bt-soft/NanoSpotWelder/README.md

# NanoSpotWelder
MOT Spot Welder Controller with Arduino Nano V3 and ATmega328P microcontroller

Full description of the project: [http://electrodiy.blog.hu/](http://electrodiy.blog.hu/2018/05/14/impulzusszamlalasos_diy_ponthegeszto_arduino_nano-val_es_atmega328p_avr_mikrokontrollerrel)

### V0.0.2 - 2018.05.23
A firmware kiegészült az impulzuscsomagok ismétlésének funkciójával. 
Új menüpontok:
 * **Packets cnt**: csomagok ismétlésének száma (értékkészlet: 1-99) 
 * **Packets pause**: az ismételt csomagok közötti várakozás (értékkészlet: 1-255)

Licence
------
##### Apache License, Version 2.0
