bt-soft/NanoSpotWelder/(list of files, drawings)

Other design files:
Proteus-model/BT - Nano Spot Welder Model.pdsprj
Proteus-model/Nano Spot Welder - Arduino Model.pdsprj
Proteus-model/Nano Spot Welder - Arduino Nano 3.pdsprj
Proteus-model/Nano Spot Welder - Arduino Nano V3 Model.pdsprj
Proteus-model/Nano Spot Welder - Arduino Nano V3.pdsprj
Proteus-model/Nano Spot Welder - BareBones Model.pdsprj
