bt-soft/NanoSpotWelder/Eagle schema/nano Spot Welder 0.0.1.sch

## EAGLE design Eagle schema/nano Spot Welder 0.0.1.sch (2018-05-13, last stored version)

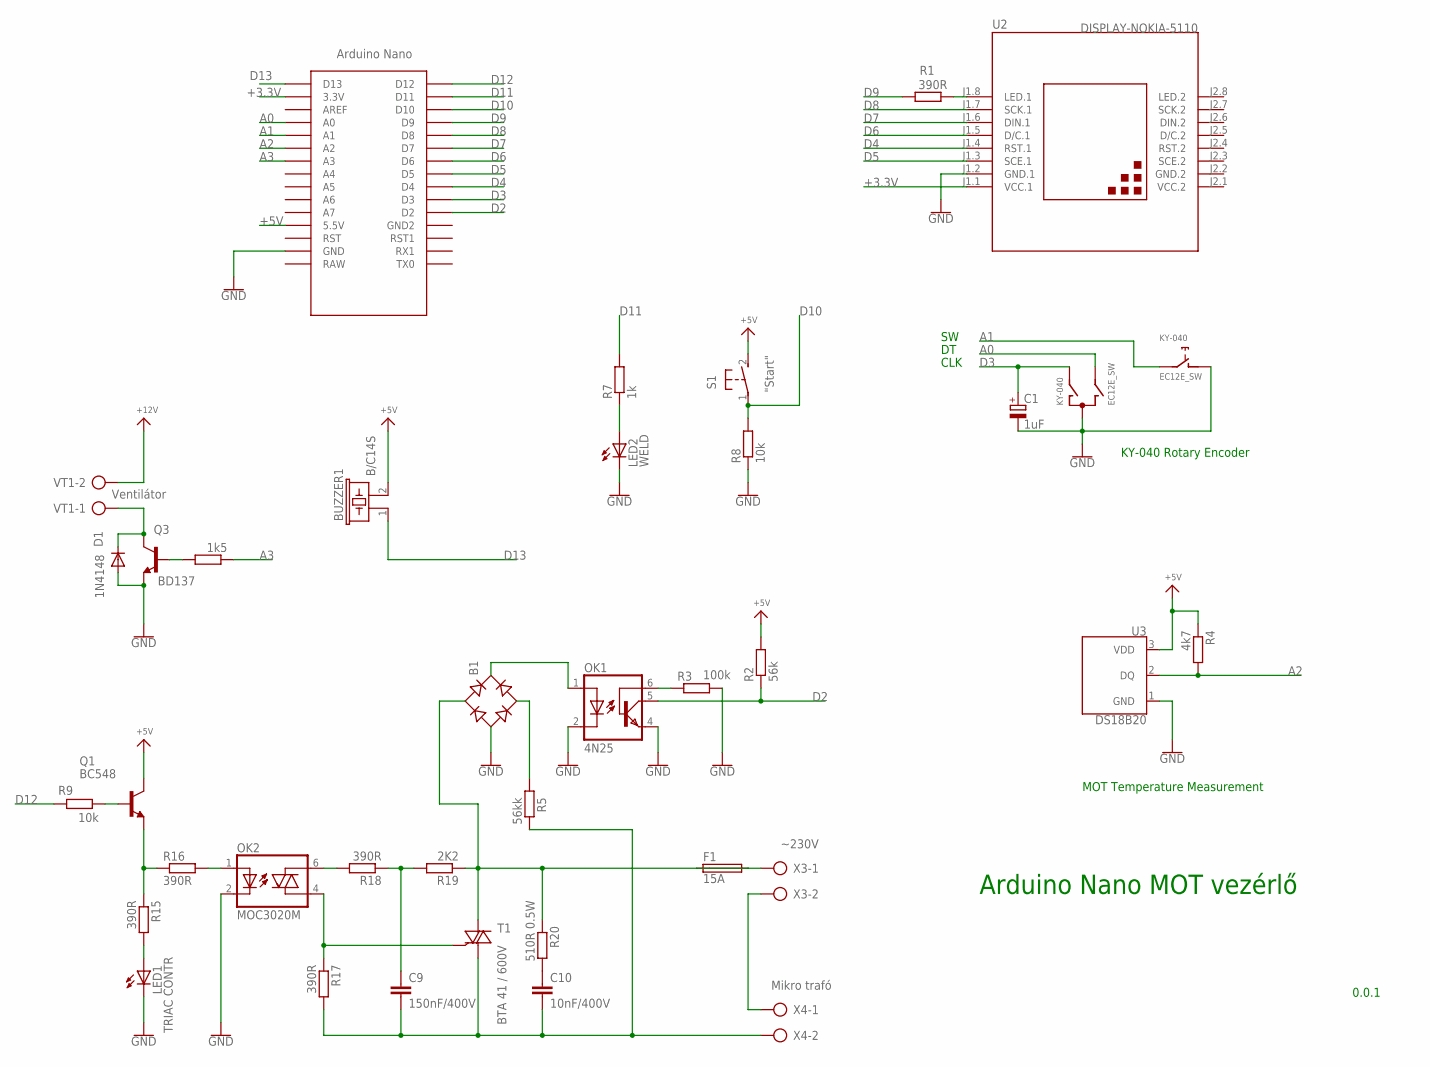
[picture p1: schematic nano Spot Welder 0.0.1.sch]

Parts:
B1: RB1A
BUZZER1: B/C14S
C1: 1uF; E5-5
C9: 150nF/400V; C5B2.5
C10: 10nF/400V; C5B2.5
D1: 1N4148; DO35-10
F1: 15A; GSH15
KY-040: EC12E_SW; ALPS_EC12E_SW
LED1: TRIAC CONTR; SMARTLED-TTW
LED2: WELD; SMARTLED-TTW
OK1: 4N25; DIL06
OK2: MOC3020M; DIL06
Q1: BC548; TO92-EBC
Q3: BD137; TO92-EBC
R1, R15, R16, R17, R18: 390R; 0204/7
R2: 56k; 0204/7
R3: 100k; 0204/7
R4: 4k7; 0204/7
R5: 56kk; 0204/7
R7: 1k; 0204/7
R8, R9: 10k; 0204/7
R10: 1k5; 0204/7
R19: 2K2; 0204/7
R20: 510R 0.5W; 0204/7
S1: 31-XX; B3F-31XX
T1: BTA 41 / 600V; TO220BV
U1: NANO
U2: DISPLAY-NOKIA-5110; DISPLAY-NOKIA-3310
U3: DS18B20; TO-92-AMMO
VT1: Ventilátor; AK300/2
X3: ~230V; AK300/2
X4: Mikro trafó; AK300/2

Connections:
+3.3V: U1.3.3V, U2.J1.1 (VCC.1)
+5V: U1.5V (5.5V)
A0: KY-040.B, U1.A0
A1: KY-040.E (2), U1.A1
A2: R4.2, U1.A2, U3.2 (DQ)
A3: R10.1, U1.A3
D2: OK1.5 (COL), R2.1, U1.D2
D3: C1.+, KY-040.A, U1.D3
D4: U1.D4, U2.J1.4 (RST.1)
D5: U1.D5, U2.J1.3 (SCE.1)
D6: U1.D6, U2.J1.5 (D/C.1)
D7: U1.D7, U2.J1.6 (DIN.1)
D8: U1.D8, U2.J1.7 (SCK.1)
D9: R1.2, U1.D9
D10: R8.2, S1.1, U1.D10
D11: R7.2, U1.D11
D12: R9.2, U1.D12
D13: BUZZER1.1, U1.D13
GND: B1.-, C1.-, D1.A, KY-040.C, KY-040.D (1), LED1.C@1 (C), LED2.C@1 (C), OK1.2 (C), OK1.4 (EMI), OK2.2 (C), Q3.E, R3.2, R8.1, U1.GND, U2.J1.2 (GND.1), U3.1 (GND)
MOC: Q1.E, R15.1, R16.1
unnamed: R1.1, U2.J1.8 (LED.1)
unnamed: OK1.6 (BAS), R3.1
unnamed: B1.+, OK1.1 (A)
unnamed: Q1.B, R9.1
unnamed: Q3.B, R10.2
unnamed: D1.C, Q3.C, VT1.1
unnamed: B1.AC2, R5.1
unnamed: OK2.6 (A2), R18.2
unnamed: LED2.A@1 (A), R7.1
unnamed: LED1.A@1 (A), R15.2
unnamed: C9.1, R18.1, R19.2
unnamed: OK2.4 (A1), R17.1, T1.G
unnamed: B1.AC1, F1.1, R19.1, R20.1, T1.T2 (A2)
unnamed: C10.1, R20.2
unnamed: X3.2, X4.1
unnamed: OK2.1 (A), R16.2
unnamed: F1.2, X3.1
unnamed: C9.2, C10.2, R5.2, R17.2, T1.T1 (A1), X4.2
VCC: BUZZER1.2, Q1.C, R2.2, R4.1, S1.2 (S), U3.3 (VDD), VT1.2

Notes on the sheet:
Arduino Nano MOT vezérlő
0.0.1
KY-040 Rotary Encoder
MOT Temperature Measurement
CLK
