bt-soft/NanoSpotWelder/RotaryEncoderWrapper.h

/*
 *
 * Copyright 2018 - BT-Soft
 *
 * Licensed under the Apache License, Version 2.0 (the "License");
 * you may not use this file except in compliance with the License.
 * You may obtain a copy of the License at
 *
 *      http://www.apache.org/licenses/LICENSE-2.0
 *
 * Unless required by applicable law or agreed to in writing, software
 * distributed under the License is distributed on an "AS IS" BASIS,
 * WITHOUT WARRANTIES OR CONDITIONS OF ANY KIND, either express or implied.
 * See the License for the specific language governing permissions and
 * limitations under the License.
 *
 * RotaryEncoderWrapper.h
 *
 *  Created on: 2018. ápr. 17.
 *      Author: bt-soft
 */

#define SMALLEST_CODESIZE
#include "ky-040.h"

#ifndef ROTARYENCODERADAPTER_H_
#define ROTARYENCODERWRAPPER_H_

//Rotary Encoder
// https://github.com/Billwilliams1952/KY-040-Encoder-Library---Arduino

/*
 * KY-040- Rotary Encoder
 *
 *
 * https://www.google.hu/imgres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
 *  +--------------+
 *  |          CLK |-- Encoder pin A
 *  |           DT |-- Encoder pin B
 *  |           SW |-- PushButton SW
 *  |         +VCC |-- +5V
 *  |          GND |-- Encoder pin C
 *  +--------------+
 *
 * https://github.com/0xPIT/encoder/issues/7
 */
/**
 * KY-040 Rotary encoder adapter
 *  - lenyomás detektálása
 *  - irány detektálása
 */
class RotaryEncoderWrapper: public ky040 {

#define ROTARY_ID1			1		/* Rotary encoder ID */

private:
	int16_t lastRotaryValue = 0;

public:
	/**
	 * Irány enum
	 */
	typedef enum Direction_t {
		UP, DOWN, NONE
	} Direction;

	/**
	 * Visszatérési érték
	 */
	typedef struct t {
		Direction_t direction;bool clicked;
	} RotaryEncoderResult;

public:
	/**
	 * Konstruktor
	 */
	RotaryEncoderWrapper(uint8_t interruptClkPin, uint8_t dataPin, uint8_t switchPin, uint8_t maxRotarys = 1) :
			ky040(interruptClkPin, dataPin, switchPin, maxRotarys) {
	}

	/**
	 * Init
	 */
	void init() {
		//--- Rotary Encoder felhúzása
		// Kezdeti érték: 0
		// Intervallum: -255...+255
		// Lépés: 1
		// Túlhajtás: igen
		ky040::AddRotaryCounter(ROTARY_ID1, 0, -255, 255, 1, true /*rollOver*/);
		ky040::SetRotary(ROTARY_ID1);
		lastRotaryValue = ky040::GetRotaryValue(ROTARY_ID1);
	}

	/**
	 * Rotary encoder olvasása, az irány meghatározása
	 */
	RotaryEncoderResult readRotaryEncoder() {

		RotaryEncoderResult result;
		result.clicked = ky040::SwitchPressed();
		result.direction = NONE;

		if (ky040::HasRotaryValueChanged(ROTARY_ID1)) {
			int16_t currentValue = ky040::GetRotaryValue(ROTARY_ID1);
			if (!result.clicked) { //Egyszerre klikkelni és tekerni nem tud
				result.direction = currentValue > lastRotaryValue ? UP : DOWN;
			}
			lastRotaryValue = currentValue;
		}

		return result;
	}
};

#endif /* ROTARYENCODERADAPTER_H_ */
