bt-soft/NanoSpotWelder/NanoSpotWelderVersion.h

/*
 * NanoSpotWelderVersion.h
 *
 *  Created on: 2018. ápr. 15.
 *      Author: BT
 */

#ifndef NSP_VERSION_H_
#define NSP_VERSION_H_


#define NSP_VERSION "0.0.1"
#define NSP_VERSION_SIZE (sizeof(NSP_VERSION))



#endif /* NSP_VERSION_H_ */
