bt-soft/NanoSpotWelder/(commit log)

2018-04-15 - LCD mainSceen - spot welding button
2018-04-15 - proteus model
    [Nano Spot Welder - Arduino Nano 3.pdsprj]
2018-04-15 - model
    [Nano Spot Welder - Arduino Nano 3.pdsprj]
2018-04-15 - LCD Menü
    [Nano Spot Welder - Arduino Nano 3.pdsprj]
2018-04-16 - rotary
    [Nano Spot Welder - Arduino Nano 3.pdsprj]
2018-04-16 - menü
    [Nano Spot Welder - Arduino Nano 3.pdsprj]
2018-04-16 - menu
    [BT - Nano Spot Welder Model.pdsprj]
2018-04-17 - rendrakás
    [Nano Spot Welder - Arduino Nano V3.pdsprj]
2018-04-17 - kódtisztítás
    [Nano Spot Welder - Arduino Nano 3.pdsprj]
2018-04-19 - Hegesztési protokoll az interrupt-ba
    [Nano Spot Welder - Arduino Nano 3.pdsprj]
2018-04-19 - msec -> str konverter
    [Nano Spot Welder - Arduino Nano 3.pdsprj]
2018-04-19 - eagle schema
    [nano Spot Welder 0.0.1.sch]
2018-04-26 - osztályokba átszervezés
    [Nano Spot Welder - Arduino Nano 3.pdsprj]
2018-04-26 - átszervezés
    [Nano Spot Welder - Arduino Nano 3.pdsprj, nano Spot Welder 0.0.1.sch]
2018-04-27 - Menü átszervezés
    [Nano Spot Welder - Arduino Nano 3.pdsprj]
2018-04-27 - kijelzés finomítás - DS18B20 kiiktatása a próbák alatt
    [Nano Spot Welder - Arduino Nano 3.pdsprj, nano Spot Welder 0.0.1.sch]
2018-05-01 - Eagle schema update
    [nano Spot Welder 0.0.1.sch]
2018-05-01 - new proteus model
    [Nano Spot Welder - Arduino Model.pdsprj, Nano Spot Welder - Arduino Nano 3.pdsprj]
2018-05-02 - próbapanel javítgatások
    [nano Spot Welder 0.0.1.sch]
2018-05-03 -Rotary Encoder 1uF
    [nano Spot Welder 0.0.1.sch]
2018-05-06 - LM335 hőmérés - összerakott egységhez hangolás - environment.h
    [nano Spot Welder 0.0.1.sch]
2018-05-06 - eagle schemas
    [nano Spot Welder (barebones) 0.0.1.sch]
2018-05-08 - LCD szintillesztő ellenállások - LCD bias & Contrast
    [nano Spot Welder (barebones) 0.0.1.sch, nano Spot Welder 0.0.1.sch]
2018-05-12 - weld button debounce
2018-05-13 - impulzus idő számítás javítás
    [Nano Spot Welder - Arduino Nano 3.pdsprj]
2018-05-13 - rajzok
    [nano Spot Welder (barebones) 0.0.1.sch, nano Spot Welder 0.0.1.sch]
